kitecraft/CandyCrane/Renders/Pulley.png

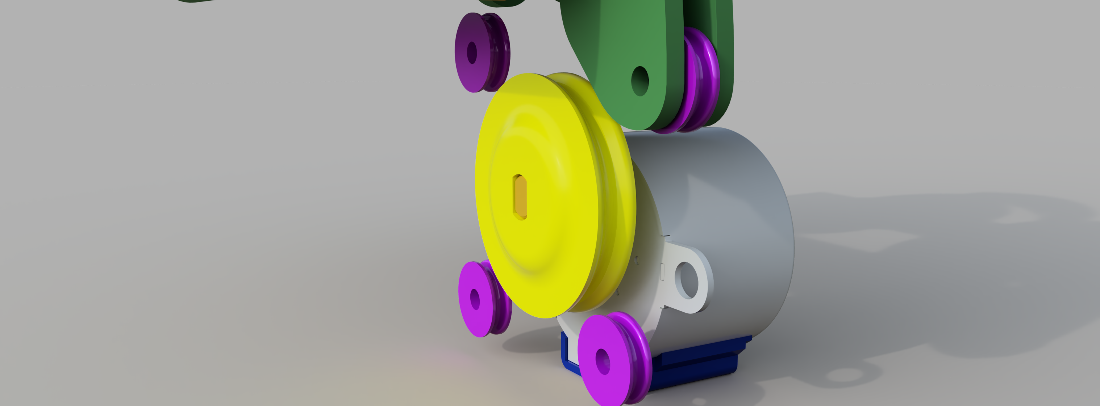
Renders/Pulley.png
