kitecraft/CandyCrane/Renders/Candy_Crane_001.png

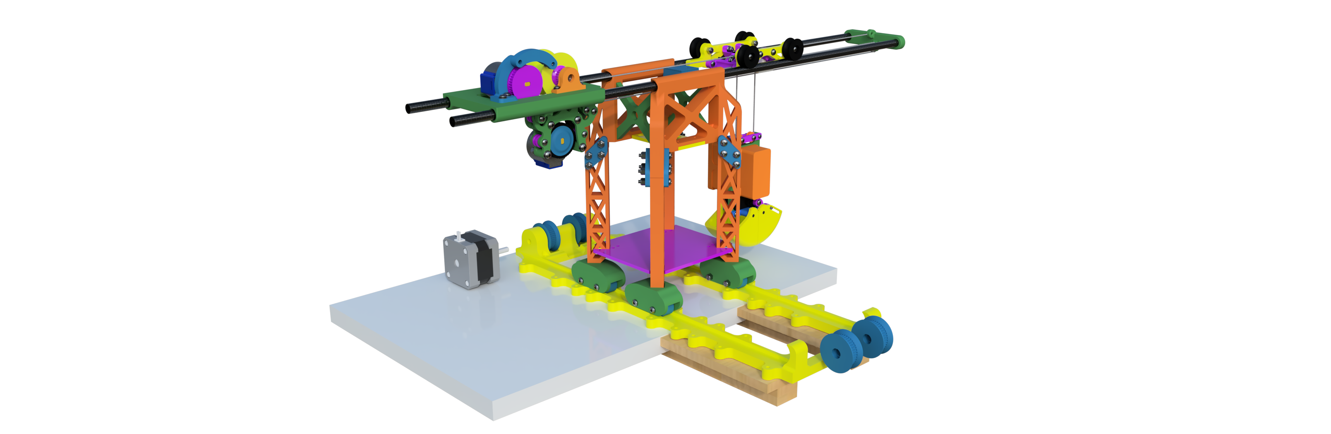
Renders/Candy_Crane_001.png
