kitecraft/CandyCrane/Renders/Bucket_001.png

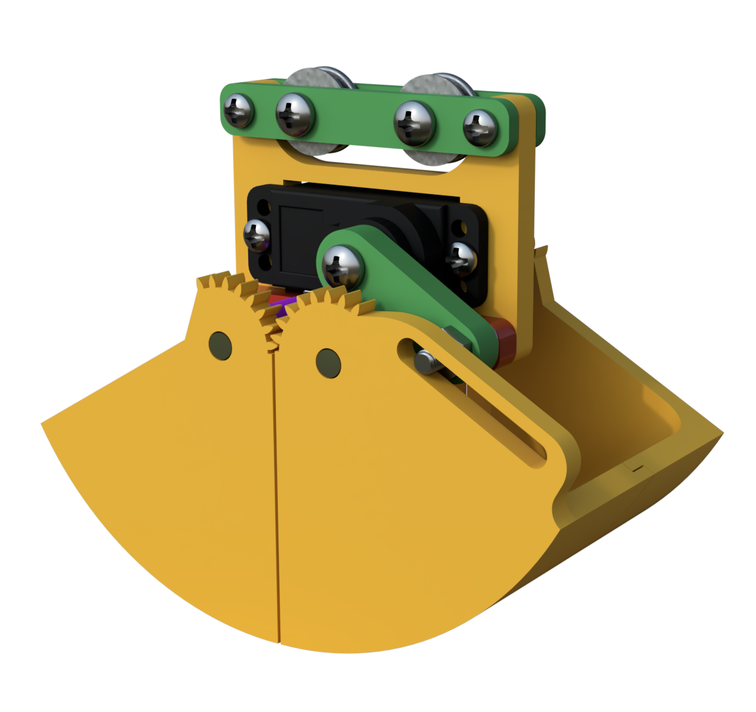
Renders/Bucket_001.png
