kitecraft/CandyCrane/Renders/Bucket_002.png

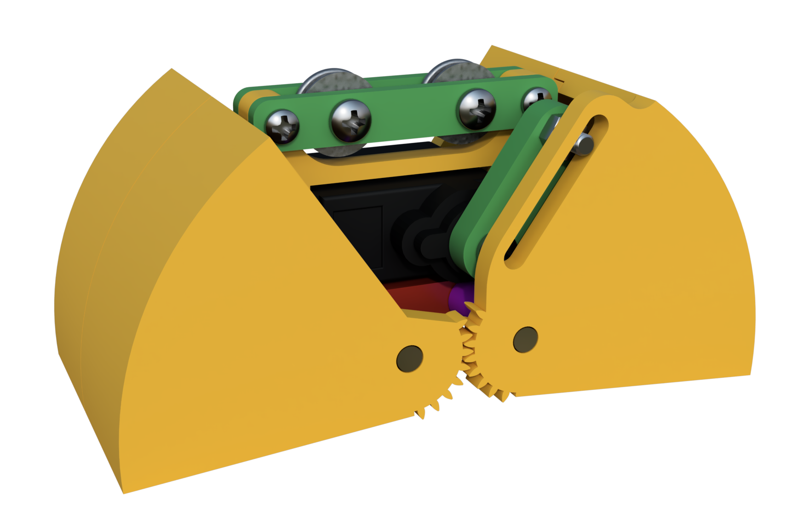
Renders/Bucket_002.png
