kitecraft/CandyCrane/Renders/Candy_Crane_001.jpg

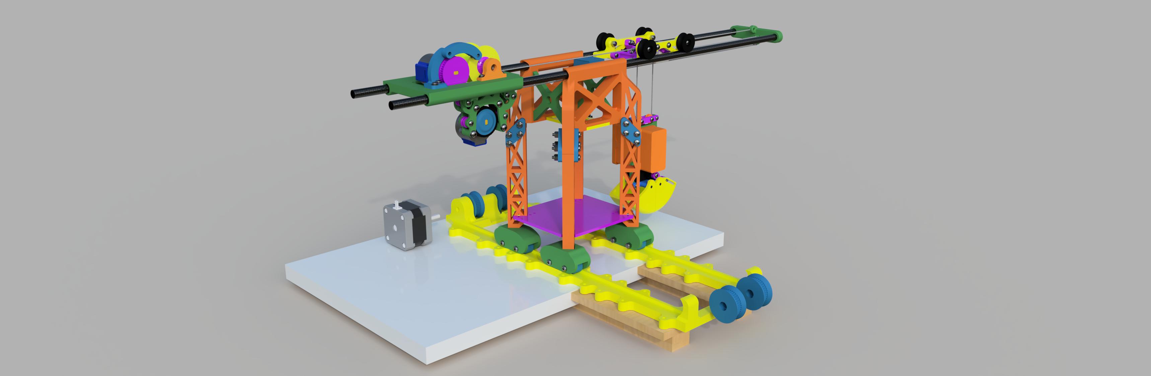
Renders/Candy_Crane_001.jpg
