kitecraft/CandyCrane/Hardware/Electronics/CCBucket/Printouts/Top and Bottom copper.pdf

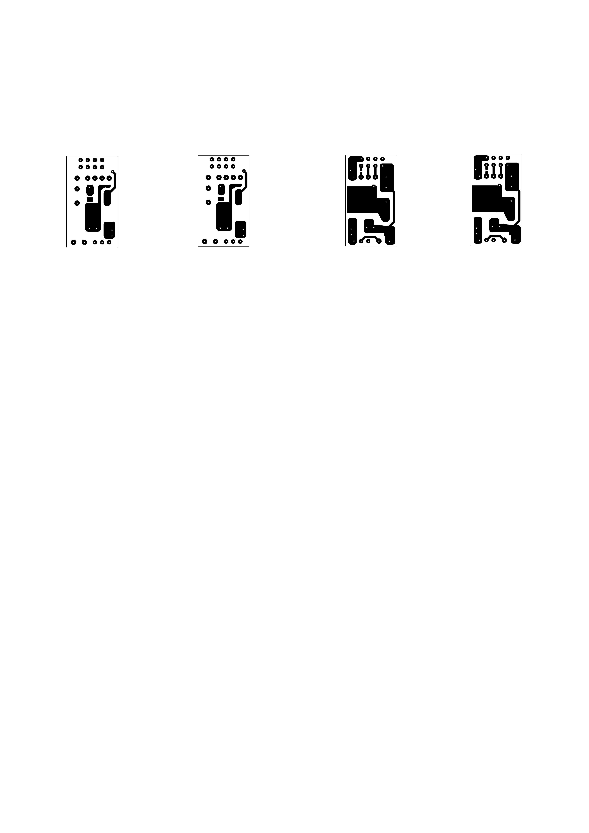
[picture p6: page 1]
