kitecraft/CandyCrane/Hardware/Electronics/CCBucket/Printouts/Bottom_copper.pdf

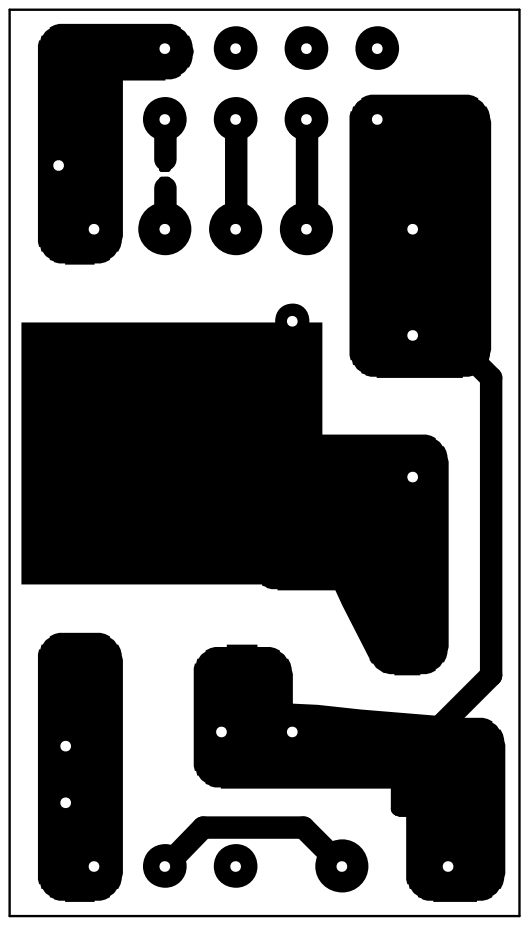
[picture p7: page 1]
