kitecraft/CandyCrane/Hardware/Electronics/CCBucket/Printouts/Top_copper.pdf

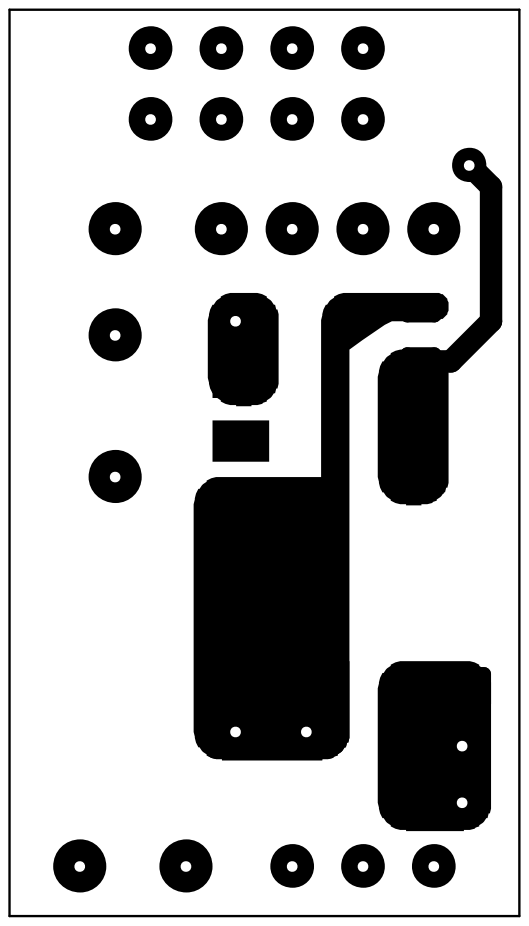
[picture p8: page 1]
