kitecraft/CandyCrane/Hardware/Electronics/CandyCrane/CandyCrane.kicad_pcb

## KiCad design Hardware/Electronics/CandyCrane/CandyCrane.kicad_pcb (2022-05-25)

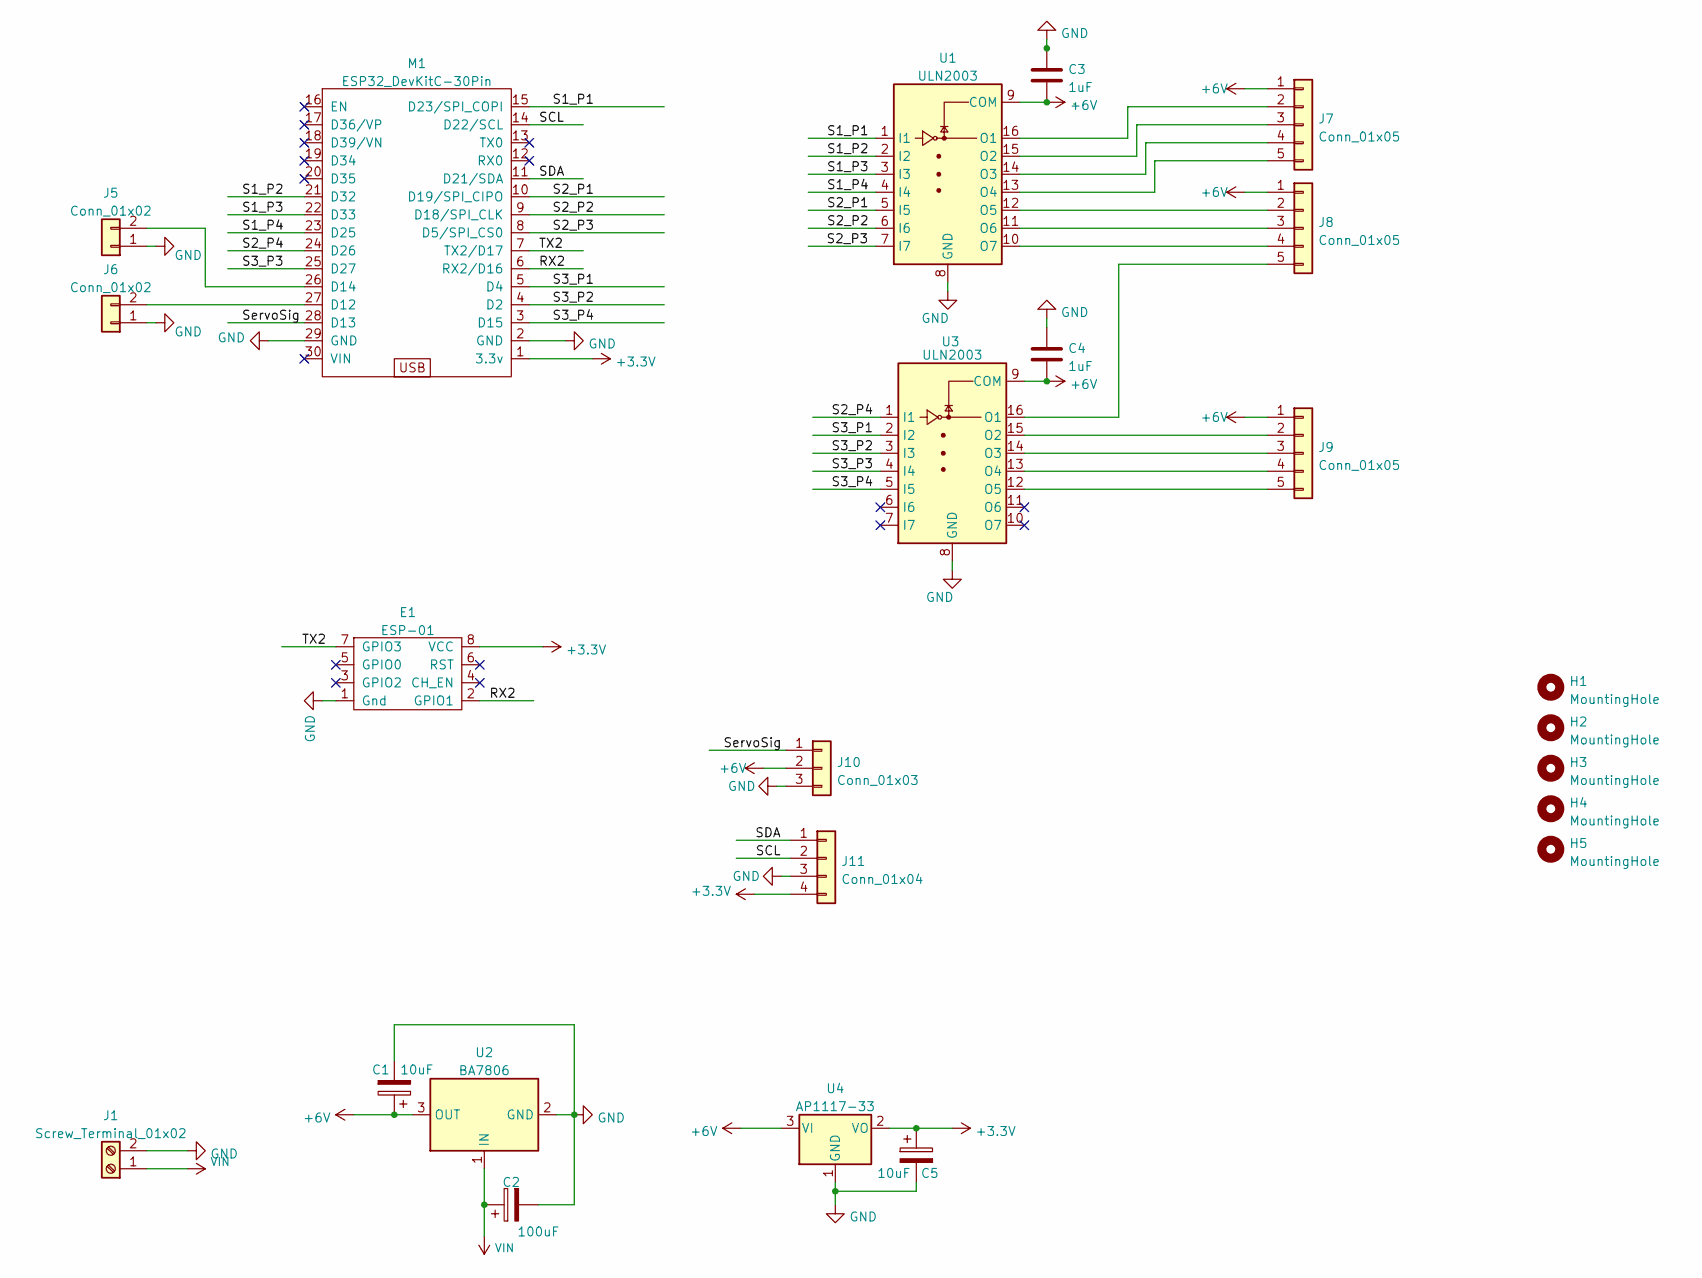
[picture p9: schematic CandyCrane.kicad_sch]

Parts:
C1, C5: 10uF; CP_EIA-3216-12_Kemet-S_Pad1.58x1.35mm_HandSolder
C2: 100uF; CP_Elec_6.3x5.9
C3, C4: 1uF; C_0805_2012Metric
E1: ESP-01; ESP-01_With_Header
H1, H2, H3, H4, H5: MountingHole; MountingHole_2.7mm
J1: Screw_Terminal_01x02; TerminalBlock_Phoenix_MKDS-1,5-2-5.08_1x02_P5.08mm_Horizont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
J5, J6: Conn_01x02; PinHeader_1x02_P2.54mm_Vertical
J7, J8, J9: Conn_01x05; PinHeader_1x05_P2.54mm_Vertical
J10: Conn_01x03; PinHeader_1x03_P2.54mm_Vertical
J11: Conn_01x04; PinHeader_1x04_P2.54mm_Vertical
M1: ESP32_DevKitC-30Pin; ESP32S_30Pin
U1, U3: ULN2003; ULN2003 on Socket
U2: BA7806; TO-252-2
U4: AP1117-33; SOT-223-3_TabPin2

Connections:
+3V3: C5.1, E1.8 (VCC), J11.4, M1.1 (3.3v), U4.2 (VO)
+6V: C1.1, C3.2, C4.2, J7.1, J8.1, J9.1, J10.2, U1.9 (COM), U2.3 (OUT), U3.9 (COM), U4.3 (VI)
/RX2: E1.2 (GPIO1), M1.6 (RX2/D16)
/S1_P1: M1.15 (D23/SPI_COPI), U1.1 (I1)
/S1_P2: M1.21 (D32), U1.2 (I2)
/S1_P3: M1.22 (D33), U1.3 (I3)
/S1_P4: M1.23 (D25), U1.4 (I4)
/S2_P1: M1.10 (D19/SPI_CIPO), U1.5 (I5)
/S2_P2: M1.9 (D18/SPI_CLK), U1.6 (I6)
/S2_P3: M1.8 (D5/SPI_CS0), U1.7 (I7)
/S2_P4: M1.24 (D26), U3.1 (I1)
/S3_P1: M1.5 (D4), U3.2 (I2)
/S3_P2: M1.4 (D2), U3.3 (I3)
/S3_P3: M1.25 (D27), U3.4 (I4)
/S3_P4: M1.3 (D15), U3.5 (I5)
/SCL: J11.2, M1.14 (D22/SCL)
/SDA: J11.1, M1.11 (D21/SDA)
/ServoSig: J10.1, M1.28 (D13)
/TX2: E1.7 (GPIO3), M1.7 (TX2/D17)
GND: C1.2, C2.2, C3.1, C4.1, C5.2, E1.1 (Gnd), J1.2, J5.1, J6.1, J10.3, J11.3, M1.2 (GND), M1.29 (GND), U1.8 (GND), U2.2 (GND), U3.8 (GND), U4.1 (GND)
unnamed: J5.2, M1.26 (D14)
unnamed: J6.2, M1.27 (D12)
unnamed: J7.2, U1.16 (O1)
unnamed: J7.3, U1.15 (O2)
unnamed: J7.4, U1.14 (O3)
unnamed: J7.5, U1.13 (O4)
unnamed: J8.2, U1.12 (O5)
unnamed: J8.3, U1.11 (O6)
unnamed: J8.4, U1.10 (O7)
unnamed: J8.5, U3.16 (O1)
unnamed: J9.2, U3.15 (O2)
unnamed: J9.3, U3.14 (O3)
unnamed: J9.4, U3.13 (O4)
unnamed: J9.5, U3.12 (O5)
VIN: C2.1, J1.1, U2.1 (IN)

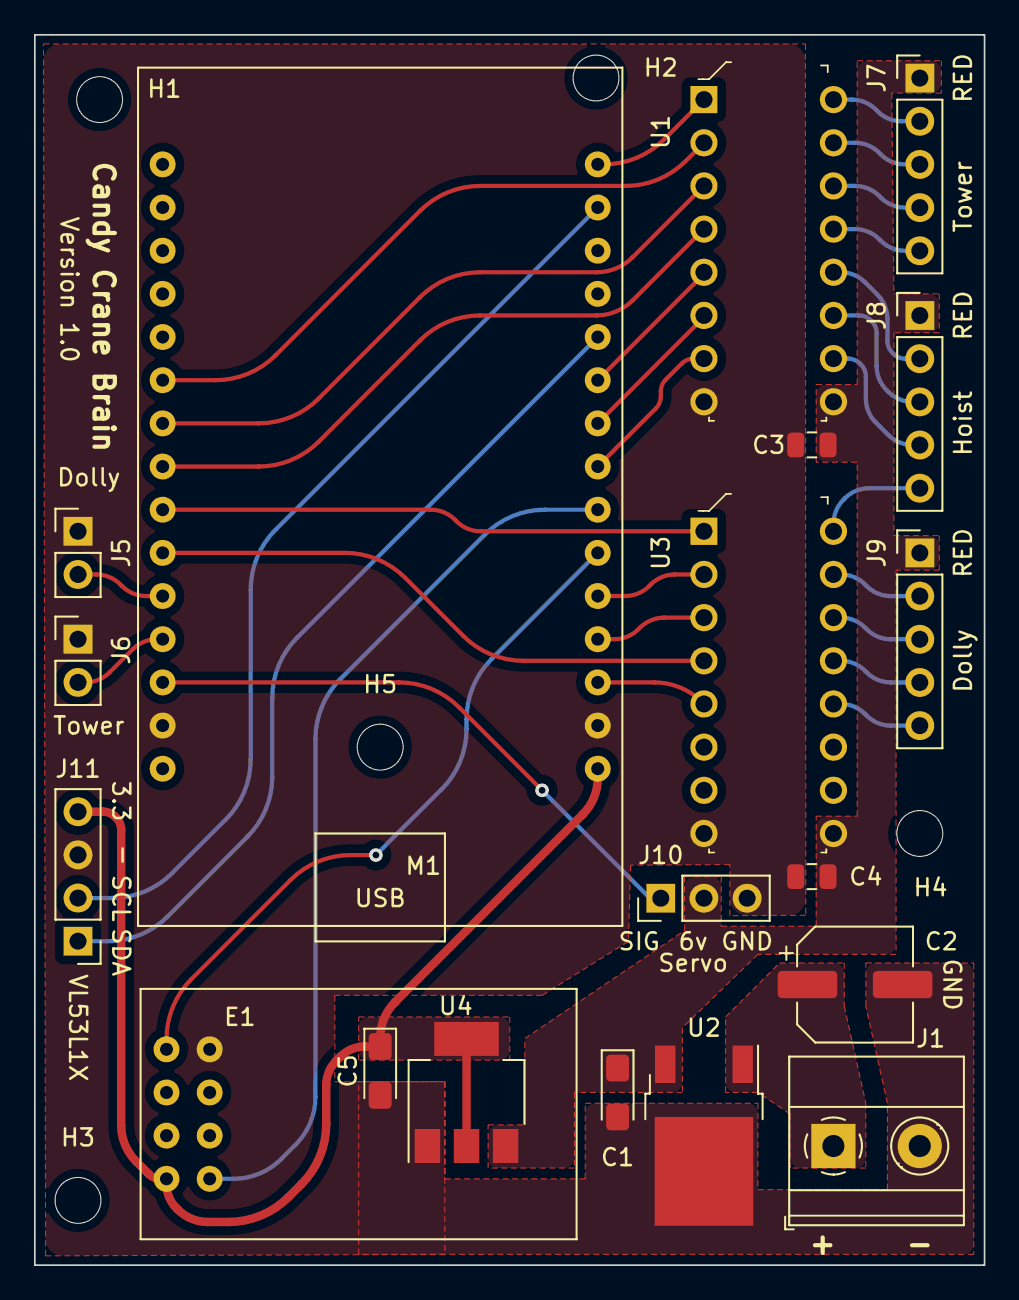
[picture p10: board CandyCrane.kicad_pcb from above]

Board: 2 copper layers, 55.9 x 72.4 mm, 24 parts (0 on the bottom side), 35 nets.
