kitecraft/CandyCrane/Hardware/Electronics/CCBucket/CCBucket.kicad_pcb

## KiCad design Hardware/Electronics/CCBucket/CCBucket.kicad_pcb (2022-04-24)

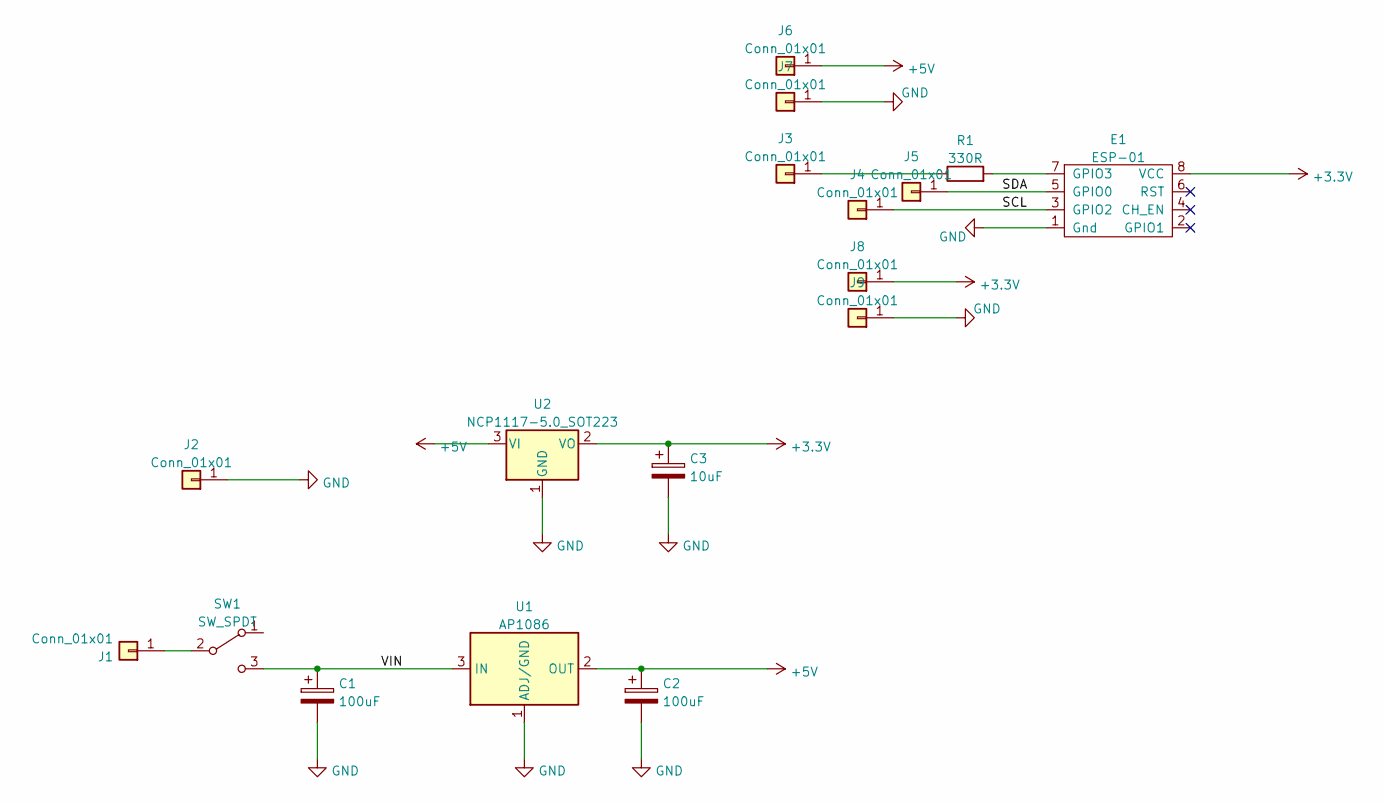
[picture p11: schematic CCBucket.kicad_sch]

Parts:
C1, C2: 100uF; CP_Elec_6.3x5.9
C3: 10uF; C_0805_2012Metric
E1: ESP-01; ESP-01_With_Header
J1, J2, J3, J4, J5, J6, J7, J8, J9: Conn_01x01; 1X01
R1: 330R; R_0201_0603Metric
SW1: SW_SPDT; SPDT_Switch_3mm
U1: AP1086; TO-263-2
U2: NCP1117-5.0_SOT223; SOT-223-3_TabPin2

Connections:
+3V3: C3.1, E1.8 (VCC), J8.1, U2.2 (VO)
+5V: C2.1, J6.1, U1.2 (OUT), U2.3 (VI)
/SCL: E1.3 (GPIO2), J4.1
/SDA: E1.5 (GPIO0), J5.1
/VIN: C1.1, SW1.3 (C), U1.3 (IN)
GND: C1.2, C2.2, C3.2, E1.1 (Gnd), J2.1, J7.1, J9.1, U1.1 (ADJ/GND), U2.1 (GND)
unnamed: E1.7 (GPIO3), R1.2
unnamed: J1.1, SW1.2 (B)
unnamed: J3.1, R1.1

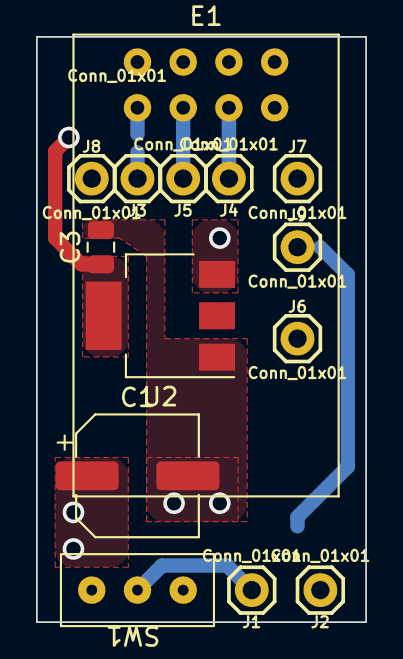
[picture p12: board CCBucket.kicad_pcb from above]

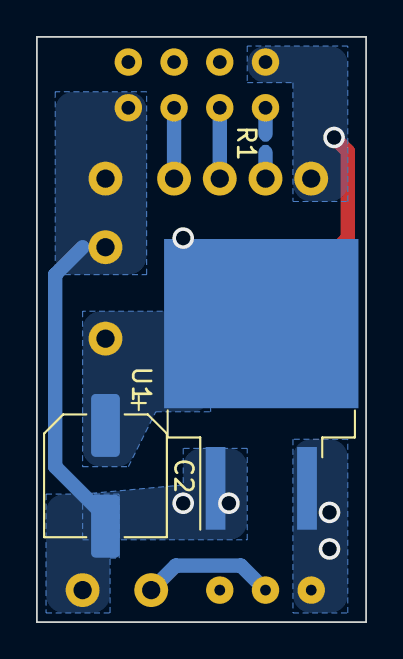
[picture p13: board CCBucket.kicad_pcb from below]

Board: 2 copper layers, 18.3 x 32.5 mm, 17 parts (3 on the bottom side), 9 nets.
