kitecraft/CandyCrane/Software/CandyCrane/src/Crane/AutoCraneSequence.h

#pragma once
#include <Arduino.h>
#include "../CC_Config.h"

extern CraneController g_craneController;
static int g_AutoCraneCurrentStep = -1;
static int g_candyDistance = -1;

/*
Take candy distance measurement
Start dolly movement outwards
Start tower movement outwards
*/
static void StartAutoCrane(int candyOption)
{

    int moveTo = 0;
    if (candyOption == 1)
    {
        moveTo = 45;
        g_candyDistance = g_craneController.GetCandy1Measurement();
        
    }
    else if (candyOption == 2) {
        moveTo = 145;
        g_candyDistance = g_craneController.GetCandy2Measurement();
    }
    else {
        return;
    }
    g_craneController.SetAutoCraneStatus(true);

    g_AutoCraneCurrentStep = 0;
    g_craneController.MoveDollyTo(190);
    vTaskDelay(3000);
    g_craneController.MoveTowerTo(moveTo);

}

static void StartAutoCrane_CandyA()
{
    StartAutoCrane(1);
}

static void StartAutoCrane_CandyB()
{
    StartAutoCrane(2);
}


static void AutoCrane_Step1()
{
    if (!g_craneController.IsDollyInMotion() && !g_craneController.IsTowerInMotion())
    {
        g_craneController.MoveBucketTo(158);
        vTaskDelay(2000);
        g_craneController.OpenBucketAsync();
        g_AutoCraneCurrentStep++;
    }
}

static void autoCrane_Step2()
{
    if (!g_craneController.IsBucketInMotion())
    {
        g_craneController.CloseBucketAsync();
        vTaskDelay(750);
        g_craneController.MoveBucketTo(20);
        g_AutoCraneCurrentStep++;
    }
}

static void autoCrane_Step3()
{
    if (!g_craneController.IsBucketInMotion())
    {
        g_craneController.MoveTowerTo(TOWER_MAXIMUM_DISTANCE);
        g_craneController.MoveDollyTo(30);
        g_AutoCraneCurrentStep++;
    }
}

static void autoCrane_Step4()
{
    if (!g_craneController.IsTowerInMotion() && !g_craneController.IsDollyInMotion())
    {
        g_craneController.MoveBucketTo(126);
        g_AutoCraneCurrentStep++;
    }
}

static void autoCrane_Step5()
{
    if (!g_craneController.IsBucketInMotion())
    {
        g_craneController.OpenBucket();
        g_craneController.MoveBucketTo(30);
        g_AutoCraneCurrentStep++;
    }
}

static void autoCrane_Step6()
{
    if (!g_craneController.IsBucketInMotion())
    {
        g_craneController.MoveTowerTo(0);
        g_craneController.MoveDollyTo(0);
        g_craneController.MoveBucketTo(0);
        g_craneController.CloseBucketAsync();
        g_AutoCraneCurrentStep++;
    }
}

static void autoCrane_Step7()
{
    if (!g_craneController.IsTowerInMotion() && !g_craneController.IsDollyInMotion())
    {
        //g_craneController.CalibrateAll();
        g_craneController.SetAutoCraneStatus(false);
        g_AutoCraneCurrentStep == -1;
        Serial.println("Sequence Complete");
    }
}

static void StopAutoCrane(){
    g_craneController.SetAutoCraneStatus(false);
    g_AutoCraneCurrentStep == -1;
}
