kitecraft/CandyCrane/(commit log)

2022-03-29 Working with geting bucket distance, as well as open and close the bucket.
2022-04-12 Many Updates
    [Mac Addys and Pin connections.ods, Mac Addys.ods]
2022-04-21 Added CCBucket PCB
    [CCBucket.kicad_pcb, CCBucket.kicad_sch]
2022-04-24 Added circuit board for bucket controller
    [CCBucket.kicad_pcb]
2022-05-08 Bucket Calibration
2022-05-13 Minor updates
    [Mac Addys and Pin connections.ods]
2022-05-21 Updated step file (CAD design)
2022-05-21 Adding more files for the Candy Crane Brain
    [CandyCrane.csv]
2022-05-25 Much work on the final stepper drivers. Adding the Kicad project for Candy Cane Brain
    [CandyCrane.kicad_pcb, CandyCrane.kicad_sch, Mac Addys and Pin connections.ods]
2022-05-26 Use ServoEasing as a pointer in CandyRanger seems to work (at least no compile errors now).
    [CandyCrane.ino, CandyRanger.cpp, CandyRanger.h]
2022-05-26 Useing ServoEasing as a pointer seems to fix the comple problems. ServoEasing *_servo = nullptr;
    [CandyRanger.h]
2023-01-22 Converted over to TCP server for Crane<->Bucket communication. Switching to use MultiTinyStepper for stepper control.
    [Mac Addys and Pin connections.ods]
2023-09-08 Switching over to my SmallFlexyStepper class
